jellewie/Arduino-Attiny-LED-Controller/Schematic_ATtiny-LED-controller_Schematic-V2_20190130080723.pdf

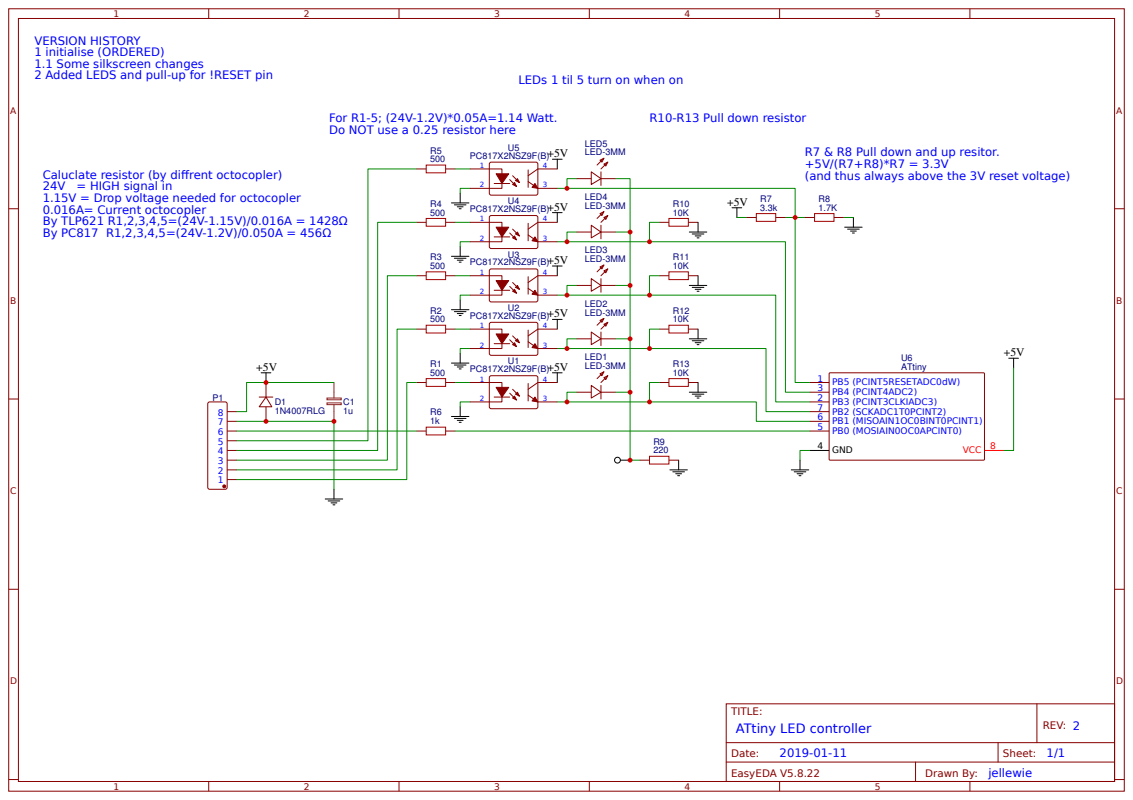
[picture p1: page 1]

VERSION HISTORY
1 initialise (ORDERED)
1.1 Some silkscreen changes
2 Added LEDS and pull-up for !RESET pin

LEDs 1 til 5 turn on when on

For R1-5; (24V-1.2V)*0.05A=1.14 Watt.
Do NOT use a 0.25 resistor here

R7 & R8 Pull down and up resitor.
(and thus always above the 3V reset voltage)

Caluclate resistor (by diffrent octocopler)
24V = HIGH signal in
1.15V = Drop voltage needed for octocopler
0.016A= Current octocopler
By TLP621 R1,2,3,4,5=(24V-1.15V)/0.016A = 1428Ω
