jellewie/Arduino-Attiny-LED-Controller/(commit log)

2018-12-14 Grammar + told PCB is V1
2019-01-11 Fixed things
    Tested it, and fixed the problems. Its PCB V2 btw
    [Arduino.ino]
2019-01-15 Tested and fixed some things
    Seem to work as intended
    [Arduino.ino]
2019-01-15 Included new PCB design
    This is the version that goes with the manual I've just made.
2019-01-30 Updated manual
    added that FastLed is needed, and the power draw of the LED's. and that a shifted ground is a common problem
2019-01-30 Added (updated) schematic
2019-01-31 60 Leds = 1 Meter, good basis
